nainaiurk/ppg_processing_unit_nrf52840/production/bom.csv

Designator | Footprint | Quantity | Value | LCSC Part #
C10, C11, C6, C9 | CAPC0603(1608)100_L | 4 | Capacitor 4.7µF +/-20% 10V 0603 | C389010
C16, C22, C4, C5 | CAPC0402(1005)60_L | 4 | Capacitor 100nF +/-20% 25V 0402 | C426067
C2 | 0402 | 1 | 0.1uF | C426067
C25, C8 | CAPC1005X55X25ML05T10 | 2 | Capacitor 1 uF +/- 10% 6.3 V 0402 | C88945
C3 | CAPC0402(1005)60_L | 1 | Capacitor 0.1uF 0402 | C426067
D1, D2, D3, D5, D6, D7, D8 | ONSC-SOD-523-2-502-01_V | 7 | ESD5Z3.3T1G | C61148
D4 | FP-APHF1608LSEEQBDZGKC-MFG | 1 | APHF1608LSEEQBDZGKC | C3019171
J1 | FP-SM02B-SRSS-TB_LF_SN-0 | 1 | SM02B-SRSS-TB(LF)(SN) | C160402
J3 | 513389873 | 1 | 51338-9873 | C122427
L1 | FP-LQM21PH_G0-IPC_C | 1 | LQM21PN2R2MGHL | C341781
R1 | 0402 | 1 | 10K | C25531
R10 | R_0603 | 1 | 0Ω | C21189
R12, R7 | RESC1005X40X25LL05T10 | 2 | 180R | C25145
R13, R4 | RESC1005X40X25LL05T10 | 2 | 10k | C25531
R18 | 0402 | 1 | 4.7K | C25900
R2 | RESC0402(1005)_L | 1 | Resistor 100K +/-1 % 0402 63 mW | C25530
R20 | 0402 | 1 | 22R | C25092
R3, R8, R9 | RESC1005X40X25ML05T05 | 3 | Resistor 4k7 +/-1% 0402 63 mW | C25900
R5 | RESC0402(1005)_L | 1 | Resistor 12K +/-1 % 0402 63 mW | C25752
R6 | RESC1005X40X25LL05T10 | 1 | 680R | C25130
SW1 | C79167_SW-SMD_EVQP7A01P | 1 | EVQP7A01P | C79167
SW2 | FP-EVP-AAU02Q-MFG | 1 | EVP-AAU02Q | C79147
U1 | C5366550_DFN-8_L3_2-W1_5-P0_9-BL | 1 | RV-3032-C7-32.768KHZ-2.5PPM-TA-QA | C5366550
U2 | FP-LGA-14L-DM00249496-MFG | 1 | ISM330DHCXTR | C2655101
U3 | QFN50P300X300X100-17N | 1 | BQ24232HARGTR | C2870612
U4 | C2650320_SON-6_L1_5-W1_0-P0_50-BL | 1 | TPS62233DRYR | C2650320
U5 | C6127317_LGA-60_L15_0-W10_0-NINA-B406-00B | 1 | NINA-B306 | C6127317
U6 | C7500179_LGA-8_L6_0-W8_0-P1_27-TL | 1 | MKDV32GCL-STP | C7500179
