nainaiurk/ppg_processing_unit_nrf52840/_restore_backup_2026-11-09T14-15-50-568/PPG_Processing_Unit.kicad_pcb

## KiCad design _restore_backup_2026-11-09T14-15-50-568/PPG_Processing_Unit.kicad_pcb (2026-11-09)

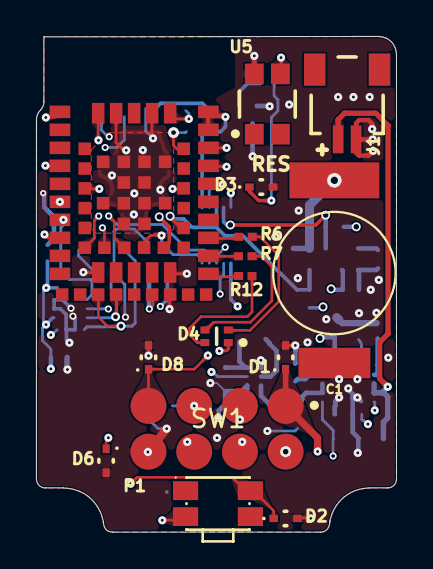
[picture p1: board PPG_Processing_Unit.kicad_pcb from above]

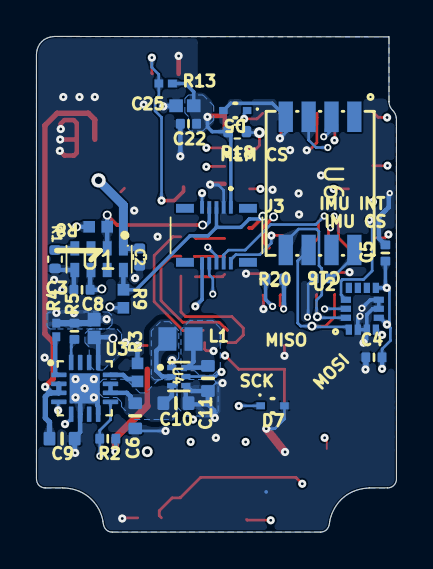
[picture p2: board PPG_Processing_Unit.kicad_pcb from below]

Board: 6 copper layers, 20.0 x 27.5 mm, 46 parts (31 on the bottom side), 40 nets.

Parts:
C1: .22F-SUPERCAP; DSK-RADIAL-6.8MM
C2: 0.1uF; C_0402_1005Metric
C3: Capacitor 0.1uF 0402; CAPC0402(1005)60_L
C4, C5, C16, C22: Capacitor 100nF +/-20% 25V 0402; CAPC0402(1005)60_L
C6, C9, C10, C11: Capacitor 4.7µF +/-20% 10V 0603; CAPC0603(1608)100_L
C8, C25: Capacitor 1 uF +/- 10% 6.3 V 0402; CAPC1005X55X25ML05T10
D1, D2, D3, D5, D6, D7, D8: ESD5Z3.3T1G; ONSC-SOD-523-2-502-01_V
D4: APHF1608LSEEQBDZGKC; FP-APHF1608LSEEQBDZGKC-MFG
J1: SM02B-SRSS-TB(LF)(SN); FP-SM02B-SRSS-TB_LF_SN-0
J3: 51338-9873; 513389873
L1: LQM21PN2R2MGHL; FP-LQM21PH_G0-IPC_C
P1: 814-22-008-30-001101; 814-22-008-30-001101-Footprint-1
R1: 10K; R_0402_1005Metric
R2: Resistor 100K +/-1 % 0402 63 mW; RESC0402(1005)_L
R3, R8, R9: Resistor 4k7 +/-1% 0402 63 mW; RESC1005X40X25ML05T05
R4, R13: 10k; RESC1005X40X25LL05T10
R5: Resistor 12K +/-1 % 0402 63 mW; RESC0402(1005)_L
R6: 680R; RESC1005X40X25LL05T10
R7, R12: 180R; RESC1005X40X25LL05T10
R18: 4.7K; R_0402_1005Metric
R20: 22R; R_0402_1005Metric
SW1: EVQP7A01P; C79167_SW-SMD_EVQP7A01P
SW2: EVP-AAU02Q; FP-EVP-AAU02Q-MFG
U1: RV-3032-C7-32.768KHZ-2.5PPM-TA-QA; C5366550_DFN-8_L3_2-W1_5-P0_9-BL
U2: ISM330DHCXTR; FP-LGA-14L-DM00249496-MFG
U3: BQ24232HARGTR; QFN50P300X300X100-17N
U4: TPS62233DRYR; C2650320_SON-6_L1_5-W1_0-P0_50-BL
U5: NINA-B302; NINA_LGA67R_1500X1000X338_PIFA
U6: MKDV32GCL-STP; C7500179_LGA-8_L6_0-W8_0-P1_27-TL

Connections:
3V0: C3.2, C4.2, C5.2, C11.2, C22.2, C25.2, D1.1 (K), D4.1 (COMMON_ANODE), J3.1, L1.2, P1.1, R2.2, R8.2, R9.2, R13.2, R18.2, SW1.2, U1.6 (VDD), U2.5 (VDDIO), U2.8 (VDD), U4.6 (FB), U5.9 (VCC_IO), U5.10 (VCC)
5V: C8.2, P1.2, U3.13 (IN)
/U_MCU/BATT_CE: U3.4 (~CE), U5.23 (GPIO_23/P0.29)
/U_MCU/FRAM_CS: R18.1, U5.36 (GPIO_36/P1.02), U6.2 (DAT3)
/U_MCU/GPIO: D8.1 (K), P1.7, U5.7 (GPIO_7/P0.25)
/U_MCU/IMU_CS: U2.12 (CS), U5.22 (GPIO_22/P1.13)
/U_MCU/IMU_INT: U2.4 (INT1), U5.21 (GPIO_21/P1.12)
/U_MCU/LED_BLUE: R7.2, U5.2 (GPIO_2/P0.14)
/U_MCU/LED_GREEN: R12.2, U5.1 (GPIO_1/P0.13)
/U_MCU/LED_RED: R6.2, U5.3 (GPIO_3/P0.15)
/U_MCU/MISO: U2.1 (SDO/SA0), U5.49 (GPIO_49/P0.22/QSPI_D2), U6.6 (DAT0)
/U_MCU/MOSI: U2.14 (SDA), U5.50 (GPIO_50/P0.20/QSPI_D0), U6.5 (CMD)
/U_MCU/PU_ANALOG: J3.9, U5.16 (GPIO_16/P0.03)
/U_MCU/PU_GPIO0: J3.8, U5.42 (GPIO_42/P0.26)
/U_MCU/PU_GPIO1: J3.6, U5.43 (GPIO_43/P0.06)
/U_MCU/PU_GPIO2: J3.4, U5.44 (GPIO_44/P0.27)
/U_MCU/PU_GPIO3: J3.2, U5.45 (GPIO_45/P0.07/TRACE_CLK)
/U_MCU/RESET: D3.1 (K), P1.6, R13.1, SW2.2?, U5.19 (RESET_N)
/U_MCU/SCK: R20.1, U2.13 (SCL), U5.52 (GPIO_52/P0.19/QSPI_CLK)
/U_MCU/SCL: J3.5, R9.1, U1.8 (SCL), U5.32 (GPIO_32/P0.11/TRACE_D2)
/U_MCU/SDA: J3.7, R8.1, U1.2 (SDA), U5.46 (GPIO_46/P0.12/TRACE_D1)
/U_MCU/SWCLK: D5.1 (K), P1.4, U5.11 (SWDCLK)
/U_MCU/SWDIO: D6.1 (K), P1.3, U5.15 (SWDIO)
/U_MCU/SWO: D7.1 (K), P1.5, U5.8 (GPIO_8/P1.00/TRACE_D0/SWO)
/U_MCU/USER_SWITCH: D2.1 (K), SW1.1', U5.34 (GPIO_34/P1.08)
/U_Power/CHG#: R2.1, U3.9 (~CHG), U5.39 (GPIO_39/P1.11)
/U_Sensors/VBACKUP: C1.+, C2.1, U1.1 (VBACKUP)
/U_UserInterface/BLUE: D4.3 (Blue_C), R7.1
/U_UserInterface/GREEN: D4.4 (Green_C), R12.1
/U_UserInterface/RED: D4.2 (Red_C), R6.1
GND: C1.-, C2.2, C3.1, C4.1, C5.1, C6.1, C8.1, C9.1, C10.1, C11.1, C16.1, C22.1, C25.1, D1.2 (A), D2.2 (A), D3.2 (A), D5.2 (A), D6.2 (A), D7.2 (A), D8.2 (A), J1.1, J3.3, P1.8, R1.1, R3.1, R4.1, R5.1, SW2.1?, U1.5 (VSS), U2.2 (SDx), U2.3 (SCx), U2.6 (GND), U2.7 (GND), U3.6 (EN1), U3.8 (VSS), U3.17 (THERMALPAD), U4.1 (MODE), U4.4 (GND), U5.6 (GND6), U5.12 (GND12), U5.14 (GND14), U5.26 (GND26), U5.30 (GND30), U5.53 (GND53), U5.56 (EGP56), U5.57 (EGP57), U5.58 (EGP58), U5.59 (EGP59), U5.60 (EGP60), U5.61 (EGP61), U5.62 (EGP62), U5.63 (EGP63), U5.64 (EGP64), U5.65 (EGP65), U5.66 (EGP66), U5.67 (EGP67), U6.4 (GND)
unnamed: C9.2, J1.2, U3.2 (BAT), U3.3 (BAT)
unnamed: R1.2, U1.4 (EVI)
unnamed: R3.2, U3.12 (ILIM)
unnamed: R5.2, U3.16 (ISET)
unnamed: R4.2, U3.1 (TS)
unnamed: L1.1, U4.2 (SW)
unnamed: R20.2, U6.3 (CLK)
unnamed: C16.2, U6.8 (VDD)
SYS_PWR: C6.2, C10.2, J3.10, U3.5 (EN2), U3.10 (OUT), U3.11 (OUT), U4.3 (VIN), U4.5 (EN)
