nainaiurk/ppg_processing_unit_nrf52840/(commit log)

2026-11-09 complete pcb with ninab302
    [MCU.kicad_sch, Memory.kicad_sch, PPG_Processing_Unit.kicad_pcb, PPG_Processing_Unit.kicad_sch, Power.kicad_sch, Sensors.kicad_sch, UserInterface.kicad_sch]
2026-11-09 changed the design accordance to b306
    [MCU.kicad_sch, Memory.kicad_sch, PPG_Processing_Unit.kicad_pcb, PPG_Processing_Unit.kicad_sch, Power.kicad_sch, Sensors.kicad_sch, UserInterface.kicad_sch, bom.csv]
2026-11-09 ADDED TEST PAD
    [MCU.kicad_sch, PPG_Processing_Unit.kicad_pcb, bom.csv, designators.csv]
2026-11-13 added a 0ohm resistor
    [PPG_Processing_Unit.kicad_pcb, Sensors.kicad_sch, bom.csv, designators.csv, positions.csv]
